StreetJr05/scara_g01_rob20262/ros2_ws/src/scara_description/meshes/base.stl

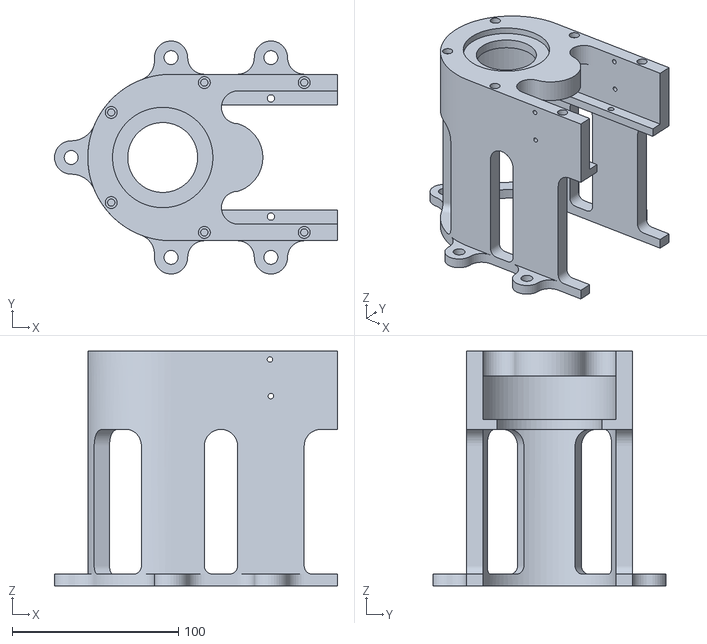
[picture p1: CAD file, 2026-10-16]
ros2_ws/src/scara_description/meshes/base.stl
170.0 x 140.0 x 141.0
