StreetJr05/scara_g01_rob20262/ros2_ws/src/scara_description/meshes/link2.stl

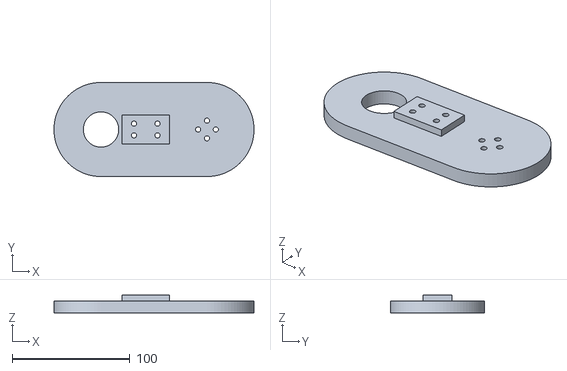
[picture p2: CAD file, 2026-10-16]
ros2_ws/src/scara_description/meshes/link2.stl
169.9 x 80.0 x 15.0
