StreetJr05/scara_g01_rob20262/ros2_ws/src/scara_description/meshes/link1.stl

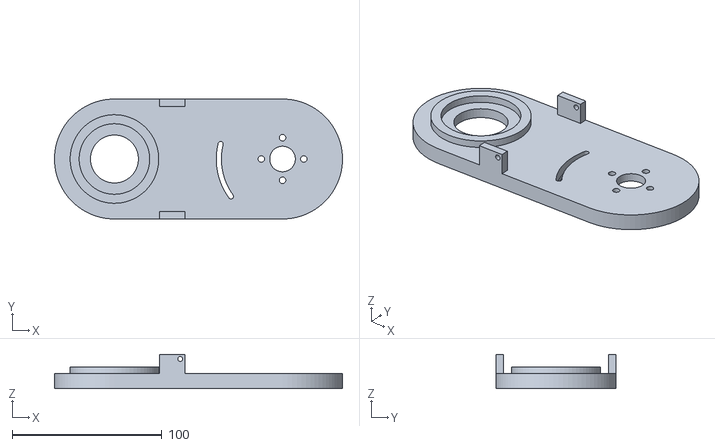
[picture p3: CAD file, 2026-10-16]
ros2_ws/src/scara_description/meshes/link1.stl
192.0 x 80.0 x 23.0
