StreetJr05/scara_g01_rob20262/results/tuning/1_driveCoast_kp4_j1/response.png

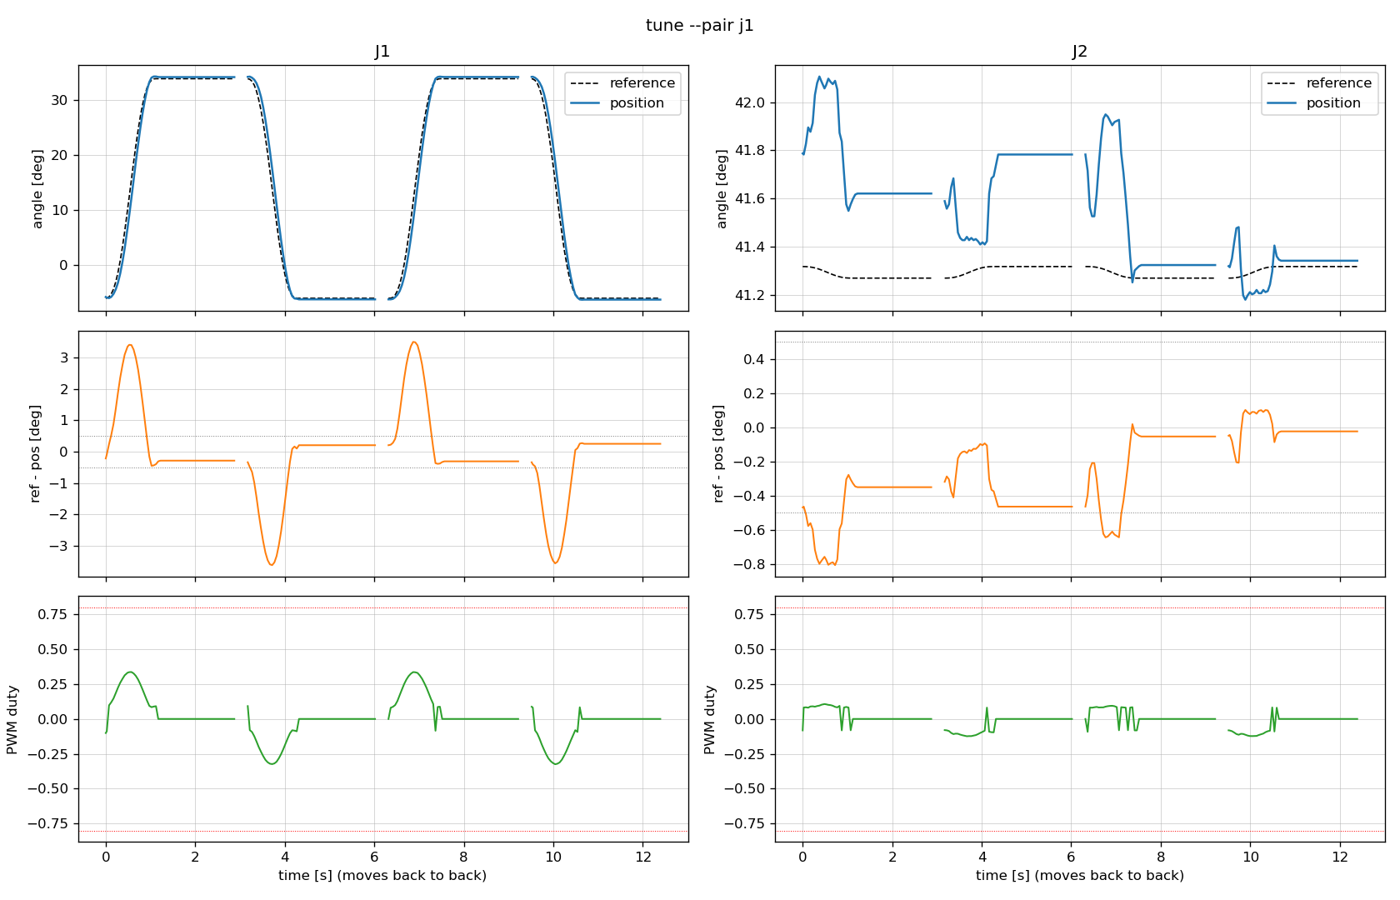
results/tuning/1_driveCoast_kp4_j1/response.png
