StreetJr05/scara_g01_rob20262/results/tuning/2_antiphase_kp4_j2/response.png

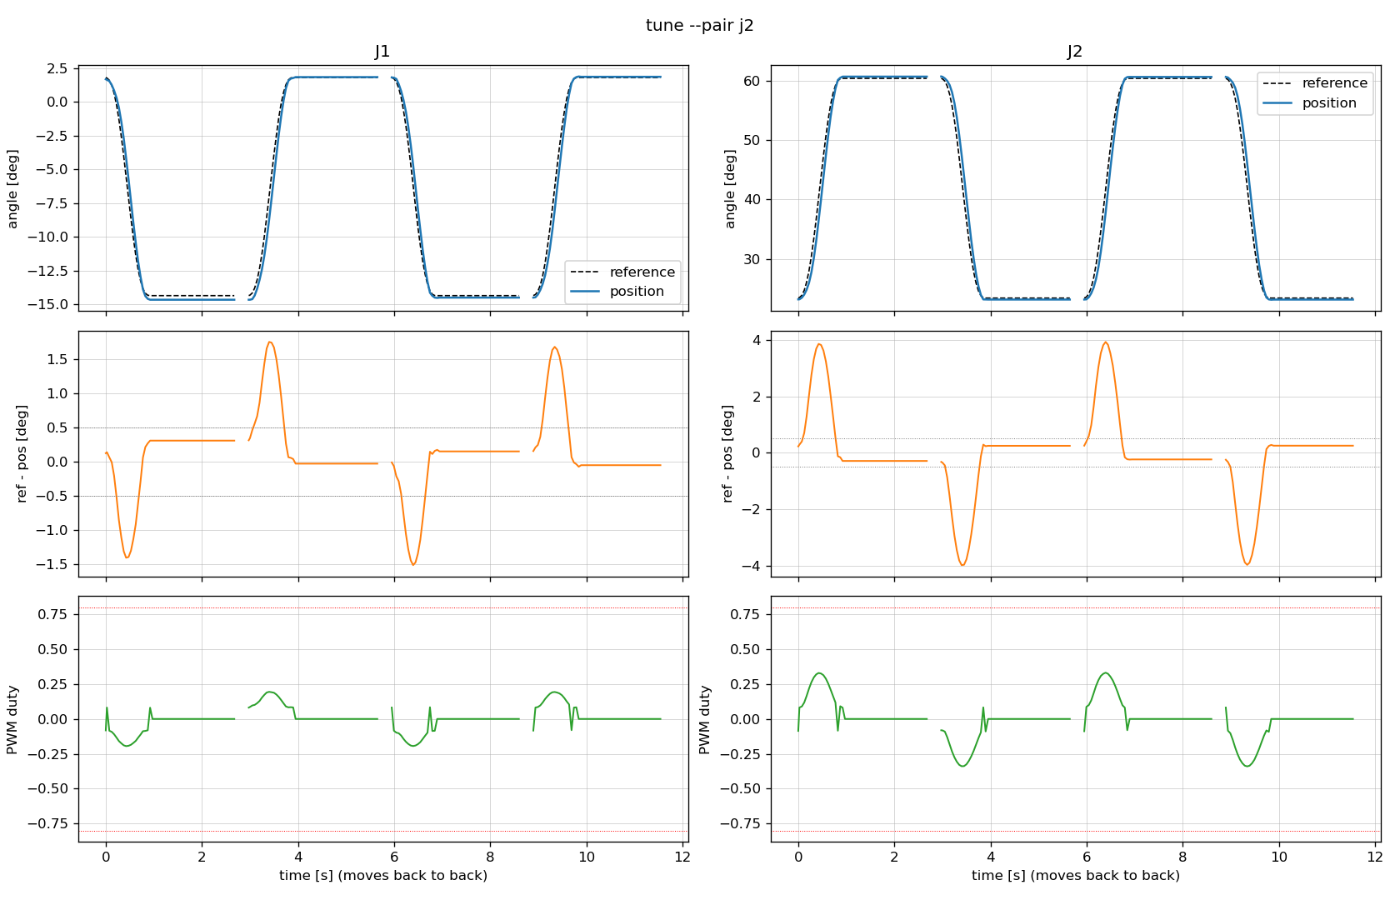
results/tuning/2_antiphase_kp4_j2/response.png
