StreetJr05/scara_g01_rob20262/results/tuning/3_antiphase_kp4_kff_tol02_j1/response.png

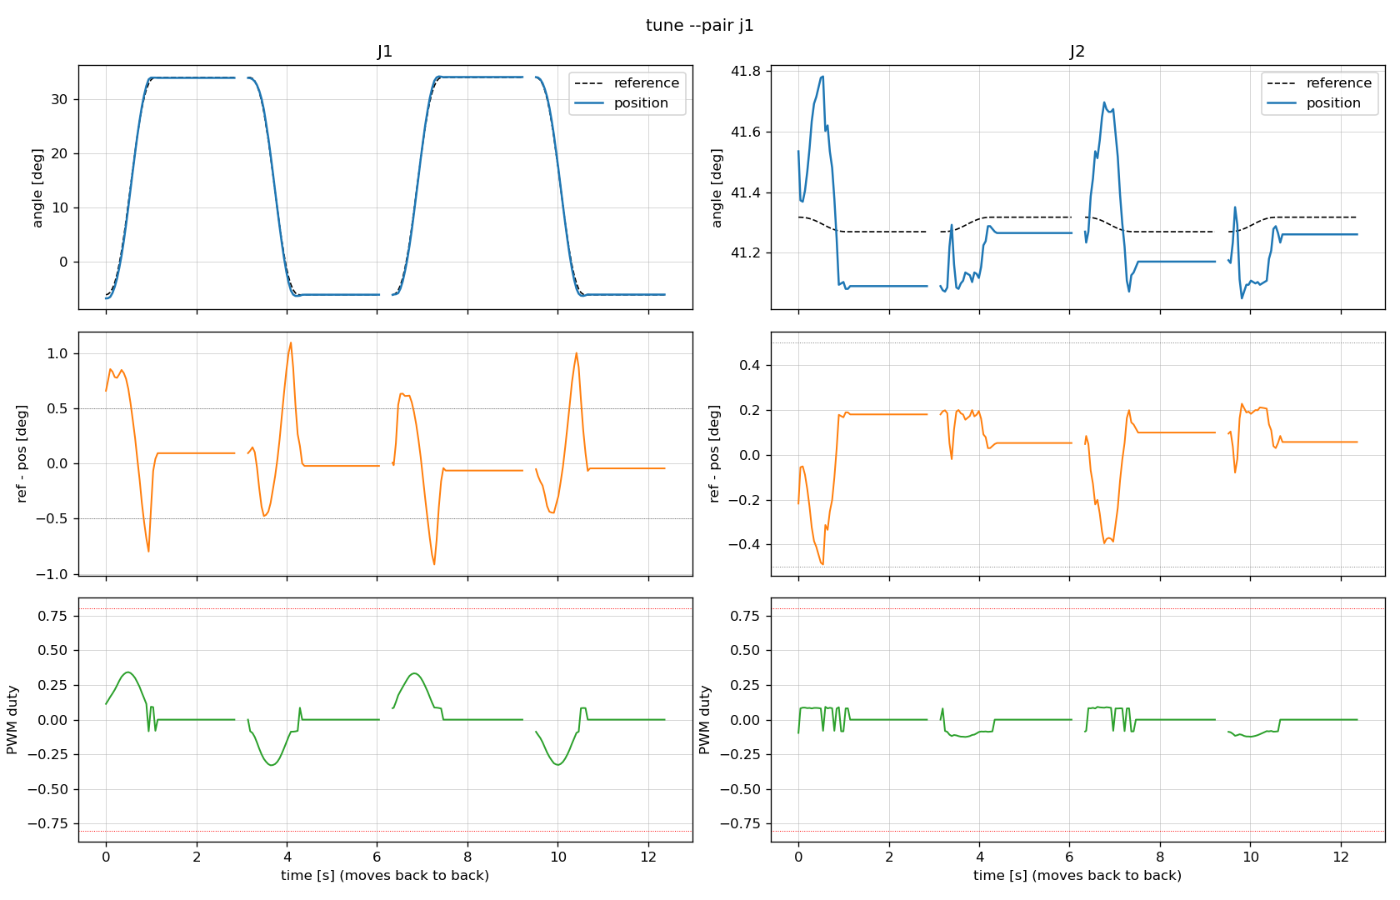
results/tuning/3_antiphase_kp4_kff_tol02_j1/response.png
