StreetJr05/scara_g01_rob20262/results/tuning/4_antiphase_kp6_kff_tol02_j2/response.png

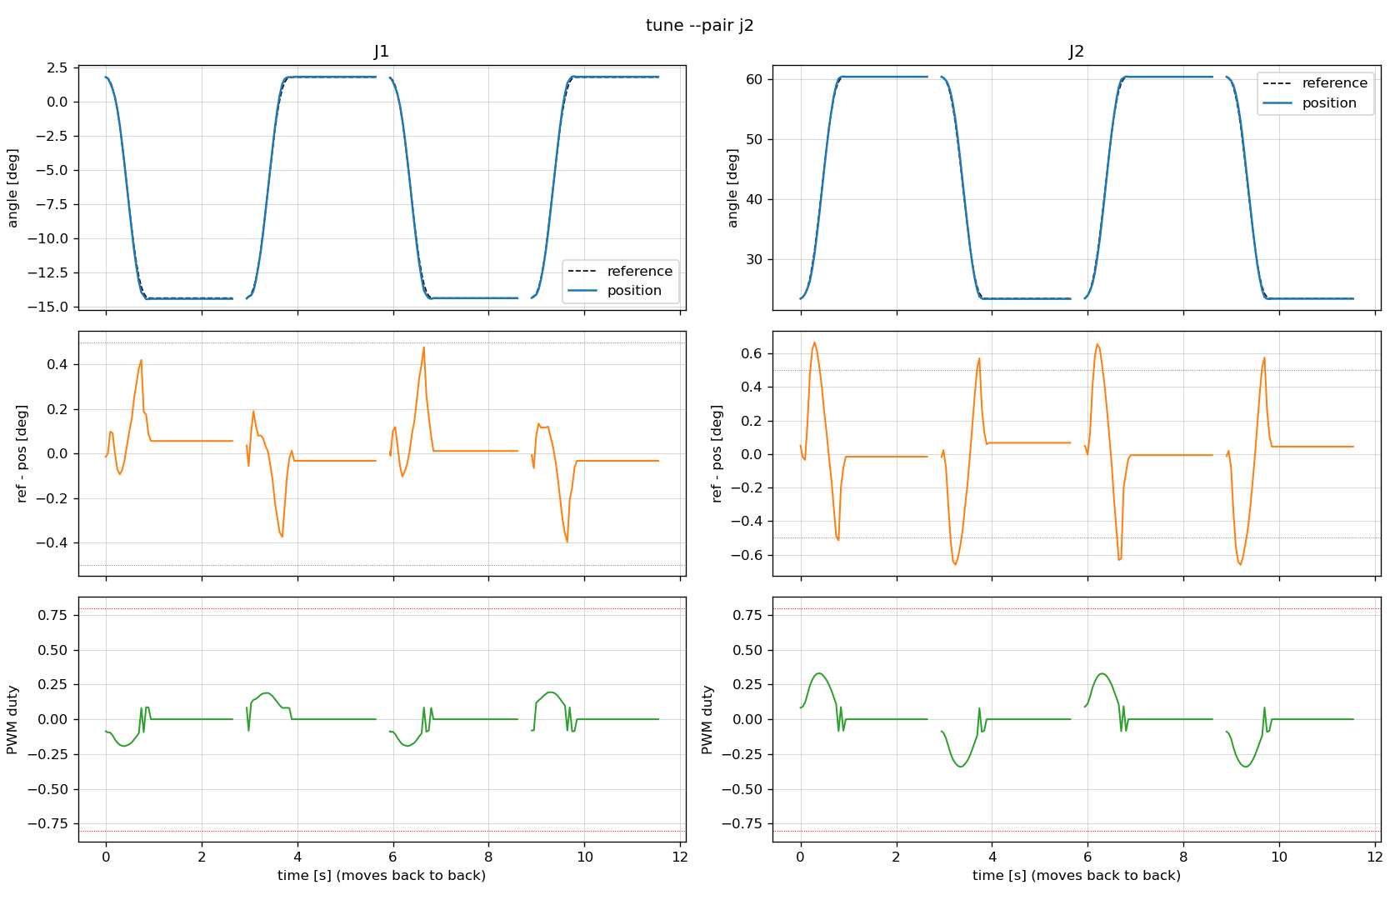
results/tuning/4_antiphase_kp6_kff_tol02_j2/response.png
