StreetJr05/scara_g01_rob20262/(commit log)

2026-10-16 Homing funciona. Solucionado el movimiento acoplado de J1 y J2. Limites de articulaciones rotativas calibrados.
2026-10-16 Correccion de accionamiento, sintonizacion de PID inicial (kff, kp 6, pos_tol 0.2 deg)
